NeedLab/face-mask-disinfection-device/docs/V2 box arduino wiring.jpg

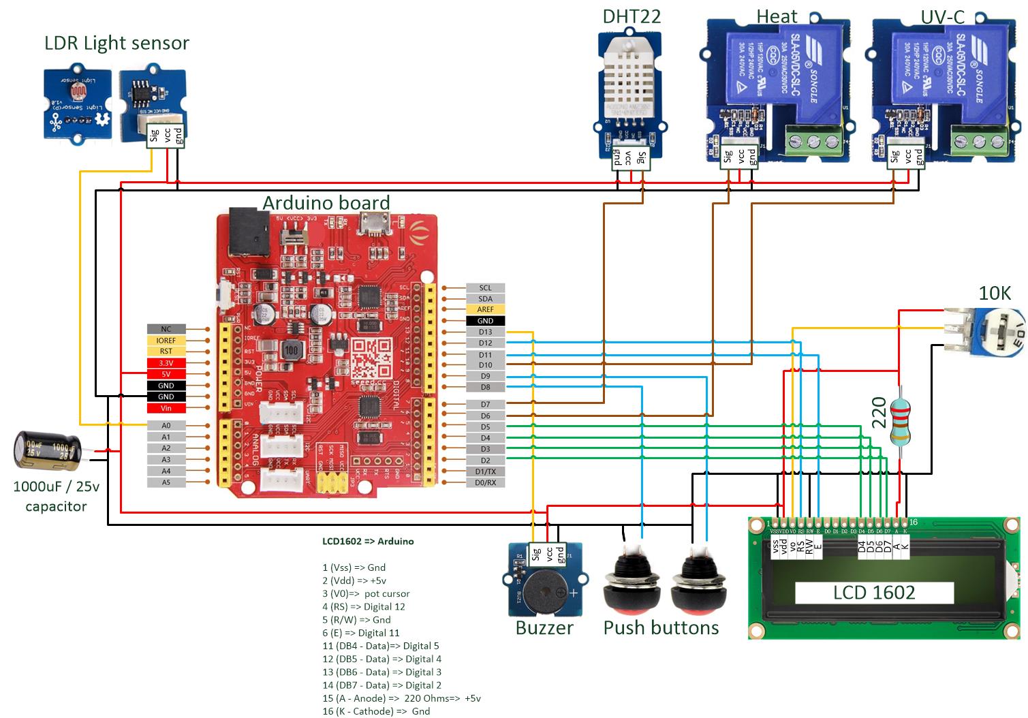
docs/V2 box arduino wiring.jpg
