NeedLab/face-mask-disinfection-device/docs/V2-schematics.jpg

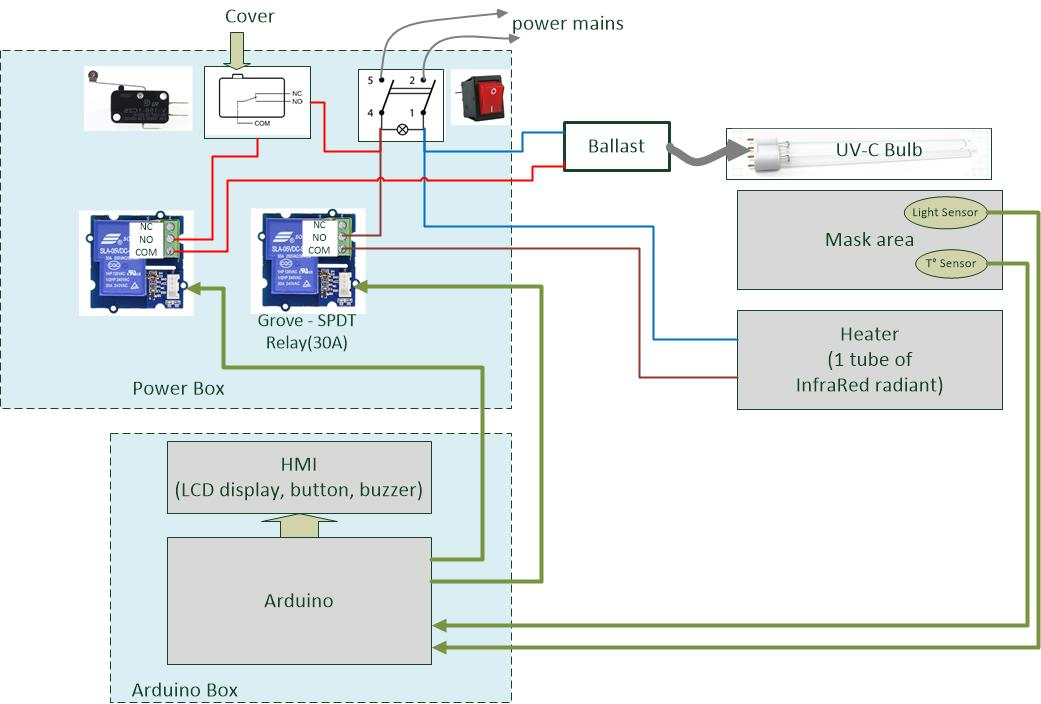
docs/V2-schematics.jpg
