NeedLab/face-mask-disinfection-device/docs/Face Mask Disinfection Device V2 BOM.xlsx

SETUP DISINFECTON BOX v2 | STUFF | Quantity | link
ARDUINO SETUP | Arduino board (Seeeduino) | 1 | https://www.seeedstudio.com/Seeeduino-V4-2-p-2517.html
 | prototyping shield | 1 | https://www.seeedstudio.com/Protoshield-Kit-for-Arduino-p-318.html
 | LCD display | 1 | https://www.seeedstudio.com/LCD-16-2-Characters-Green-Yellow-back-light-p-62.html
 | LCD display (alternative) |  | https://www.seeedstudio.com/Grove-16x2-LCD-White-on-Blue.html
 | Light sensor | 1 | https://www.seeedstudio.com/Grove-Light-Sensor-p-1253.html
 | temperature & humidity sensor DHT22 | 1 | https://www.seeedstudio.com/Grove-Temperature-Humidity-Sensor-Pro-AM2302-DHT22.html
 | Relay | 2 | https://www.seeedstudio.com/Grove-SPDT-Relay-30A.html
 | 12mm Domed Push Button Pack | 1 | https://www.seeedstudio.com/12mm-Domed-Push-Button-Pack-p-1304.html
 | Buzzer | 1 | https://www.seeedstudio.com/Grove-Buzzer.html
 | Grove - 4 pin Male Jumper to Grove 4 pin Conversion Cable (5 PCs per Pack) | 1 | https://www.seeedstudio.com/Grove-4-pin-Male-Jumper-to-Grove-4-pin-Conversion-Cable-5-PCs-per-Pack.html
 | 1000uF 25v capacitor
 | wall adapter supply | 1 | https://www.seeedstudio.com/Wall-Adapter-Power-Supply-12VDC-1-2A-Includes-5-adapter-plugs.html
ELECTRIC SETUP | Miniature Basic Switch | 1 | https://fr.rs-online.com/web/p/microrupteurs/6822786/
 | manual switch | 1 | https://fr.rs-online.com/web/p/interrupteurs-a-bascule/1858229/
 | UV-C lamp & Ballast | 1 | https://www.aqua-store.fr/filtre-sterelisateur-uv-aquarium/9731-aqua-nova-steriliser-36-w-filtre-uv-pour-aquarium-5907747866294.html
 | Infra Red Heater | 1 | https://fr.trotec.com/shop/radiant-infrarouge-electrique-ir-1200-s.html
VARIOUS STUFF | Aluminium tape | 1 | https://fr.rs-online.com/web/p/rubans-aluminium/0176573/
 | lockers (2x pack) | 1 | https://fr.rs-online.com/web/p/fermetures-a-bascule/1974110/
 | hinges (2X pack) | 1 | https://fr.aliexpress.com/item/4000093145544.html
 | Metal plate | 1
 | wood | tbd
