NeedLab/face-mask-disinfection-device/docs/V2-pin-mapping.ods

UNO | LCD1602 | Grove LCD | Piezo Buzzer | BPs | Relay Heat | Relay UV-C | DHT22 | Adafruit UV sensor | Grove Light Sensor
GND | 1 - GND | GND | GND | GND | GND | GND | GND | GND | GND
GND | 5 -R/W
5V | 2 - VDD | VCC |  |  | VCC | VCC | VCC | VCC | VCC
D2 | 14 - DB7
D3 | 13 - DB6
D4 | 12 - DB5
D5 | 11 - DB4
D6 |  |  |  |  | SIG
D7 |  |  |  |  |  |  | OUT
D8 |  |  |  | Mode
D9 |  |  |  | Start / Stop
D10 |  |  |  |  |  | SIG
D11 | 6- E
D12 | 4 - RS
D13 (Led) |  |  | SIG
A0 |  |  |  |  |  |  |  | OUT | SIG
A1
A2
A3
A4 (SDA) |  | SDA
A5 (SCL) |  | SCL
D0 (Tx)
D1 (Rx)
