NeedLab/face-mask-disinfection-device/design/Electronics-power-Box-thck5.pdf

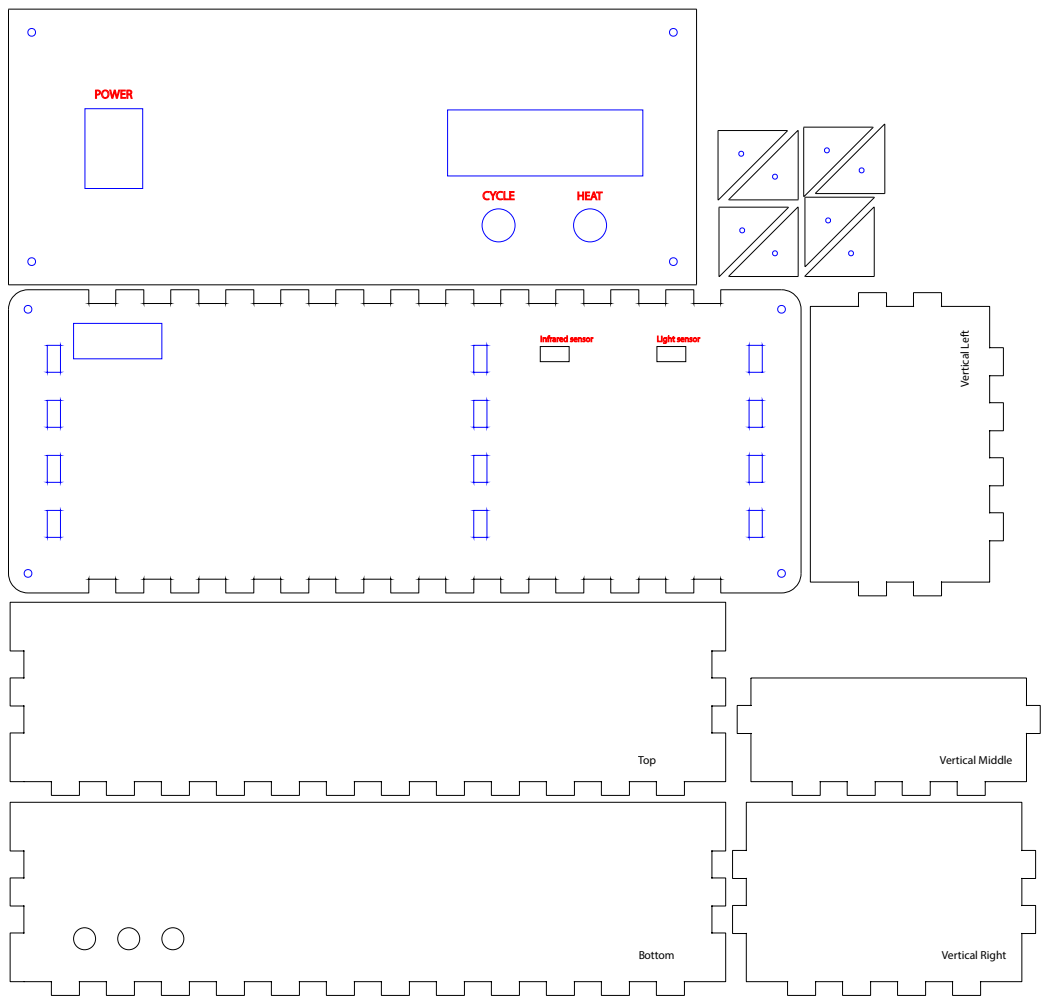
[picture p3: page 1]
Bottom; Top; Vertical Middle

Vertical Right Vertical Left
