NeedLab/face-mask-disinfection-device/design/Laser-cutting-Big-Box-500x600-thck10-all.pdf

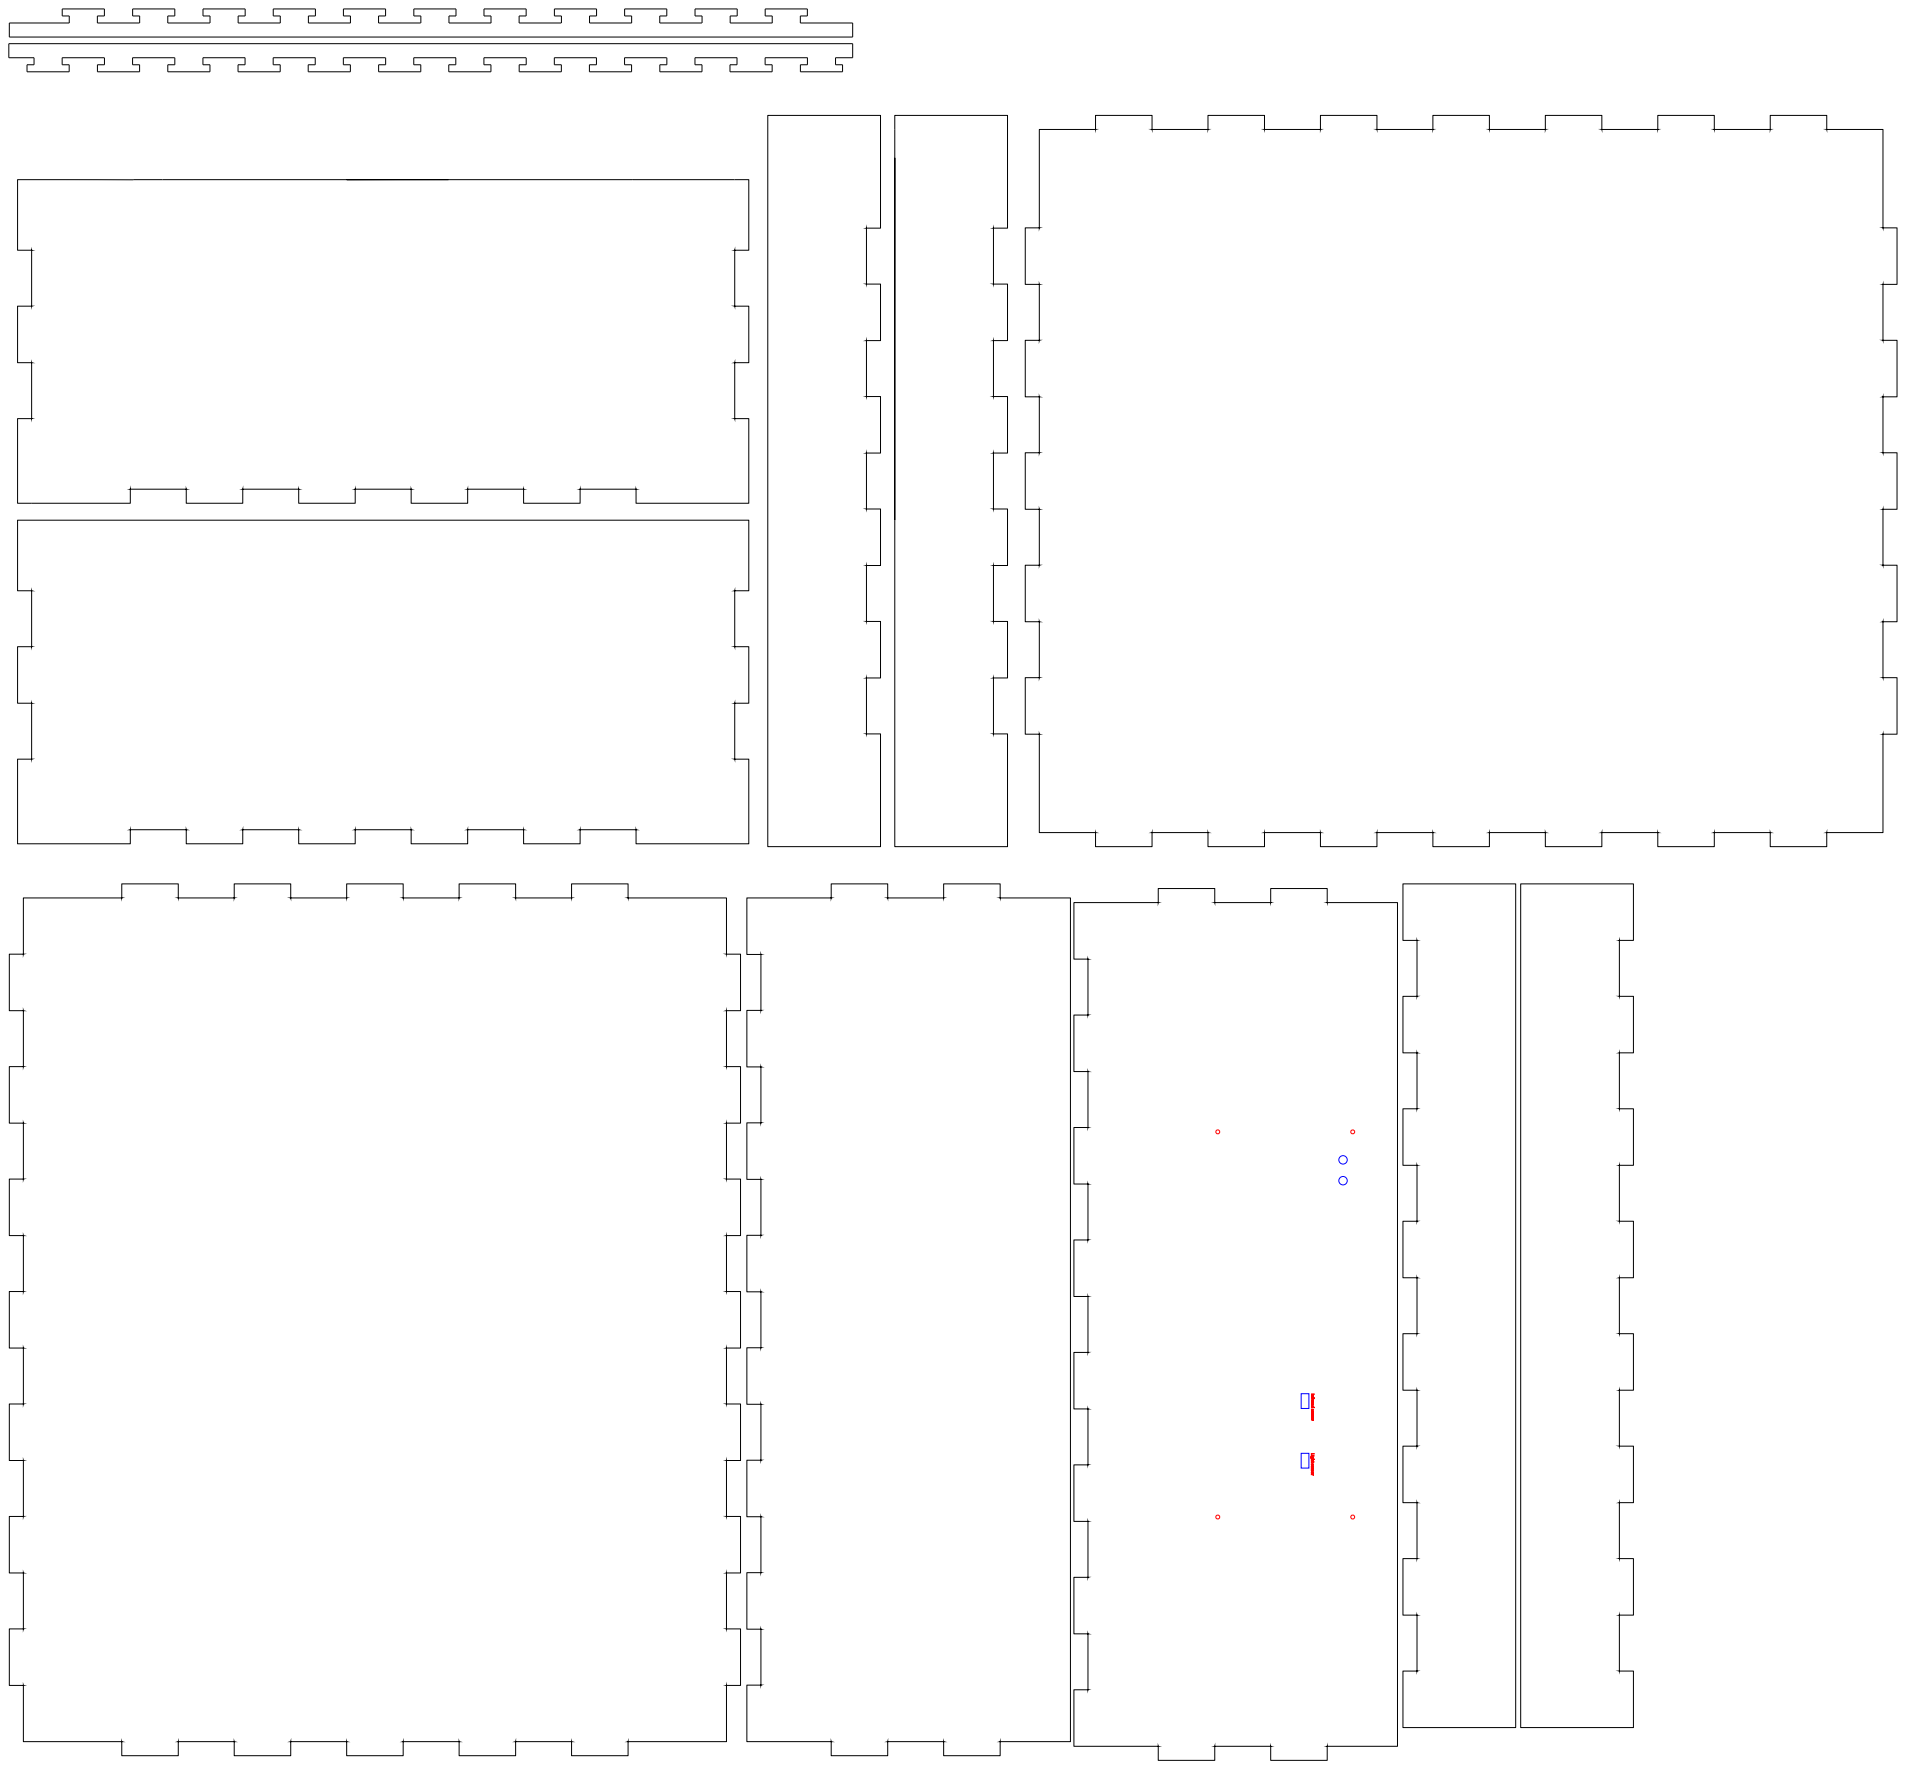
[picture p4: page 1]
