NeedLab/face-mask-disinfection-device/design/Laser-cutting-Big-Box-500x600-thck8-all.pdf

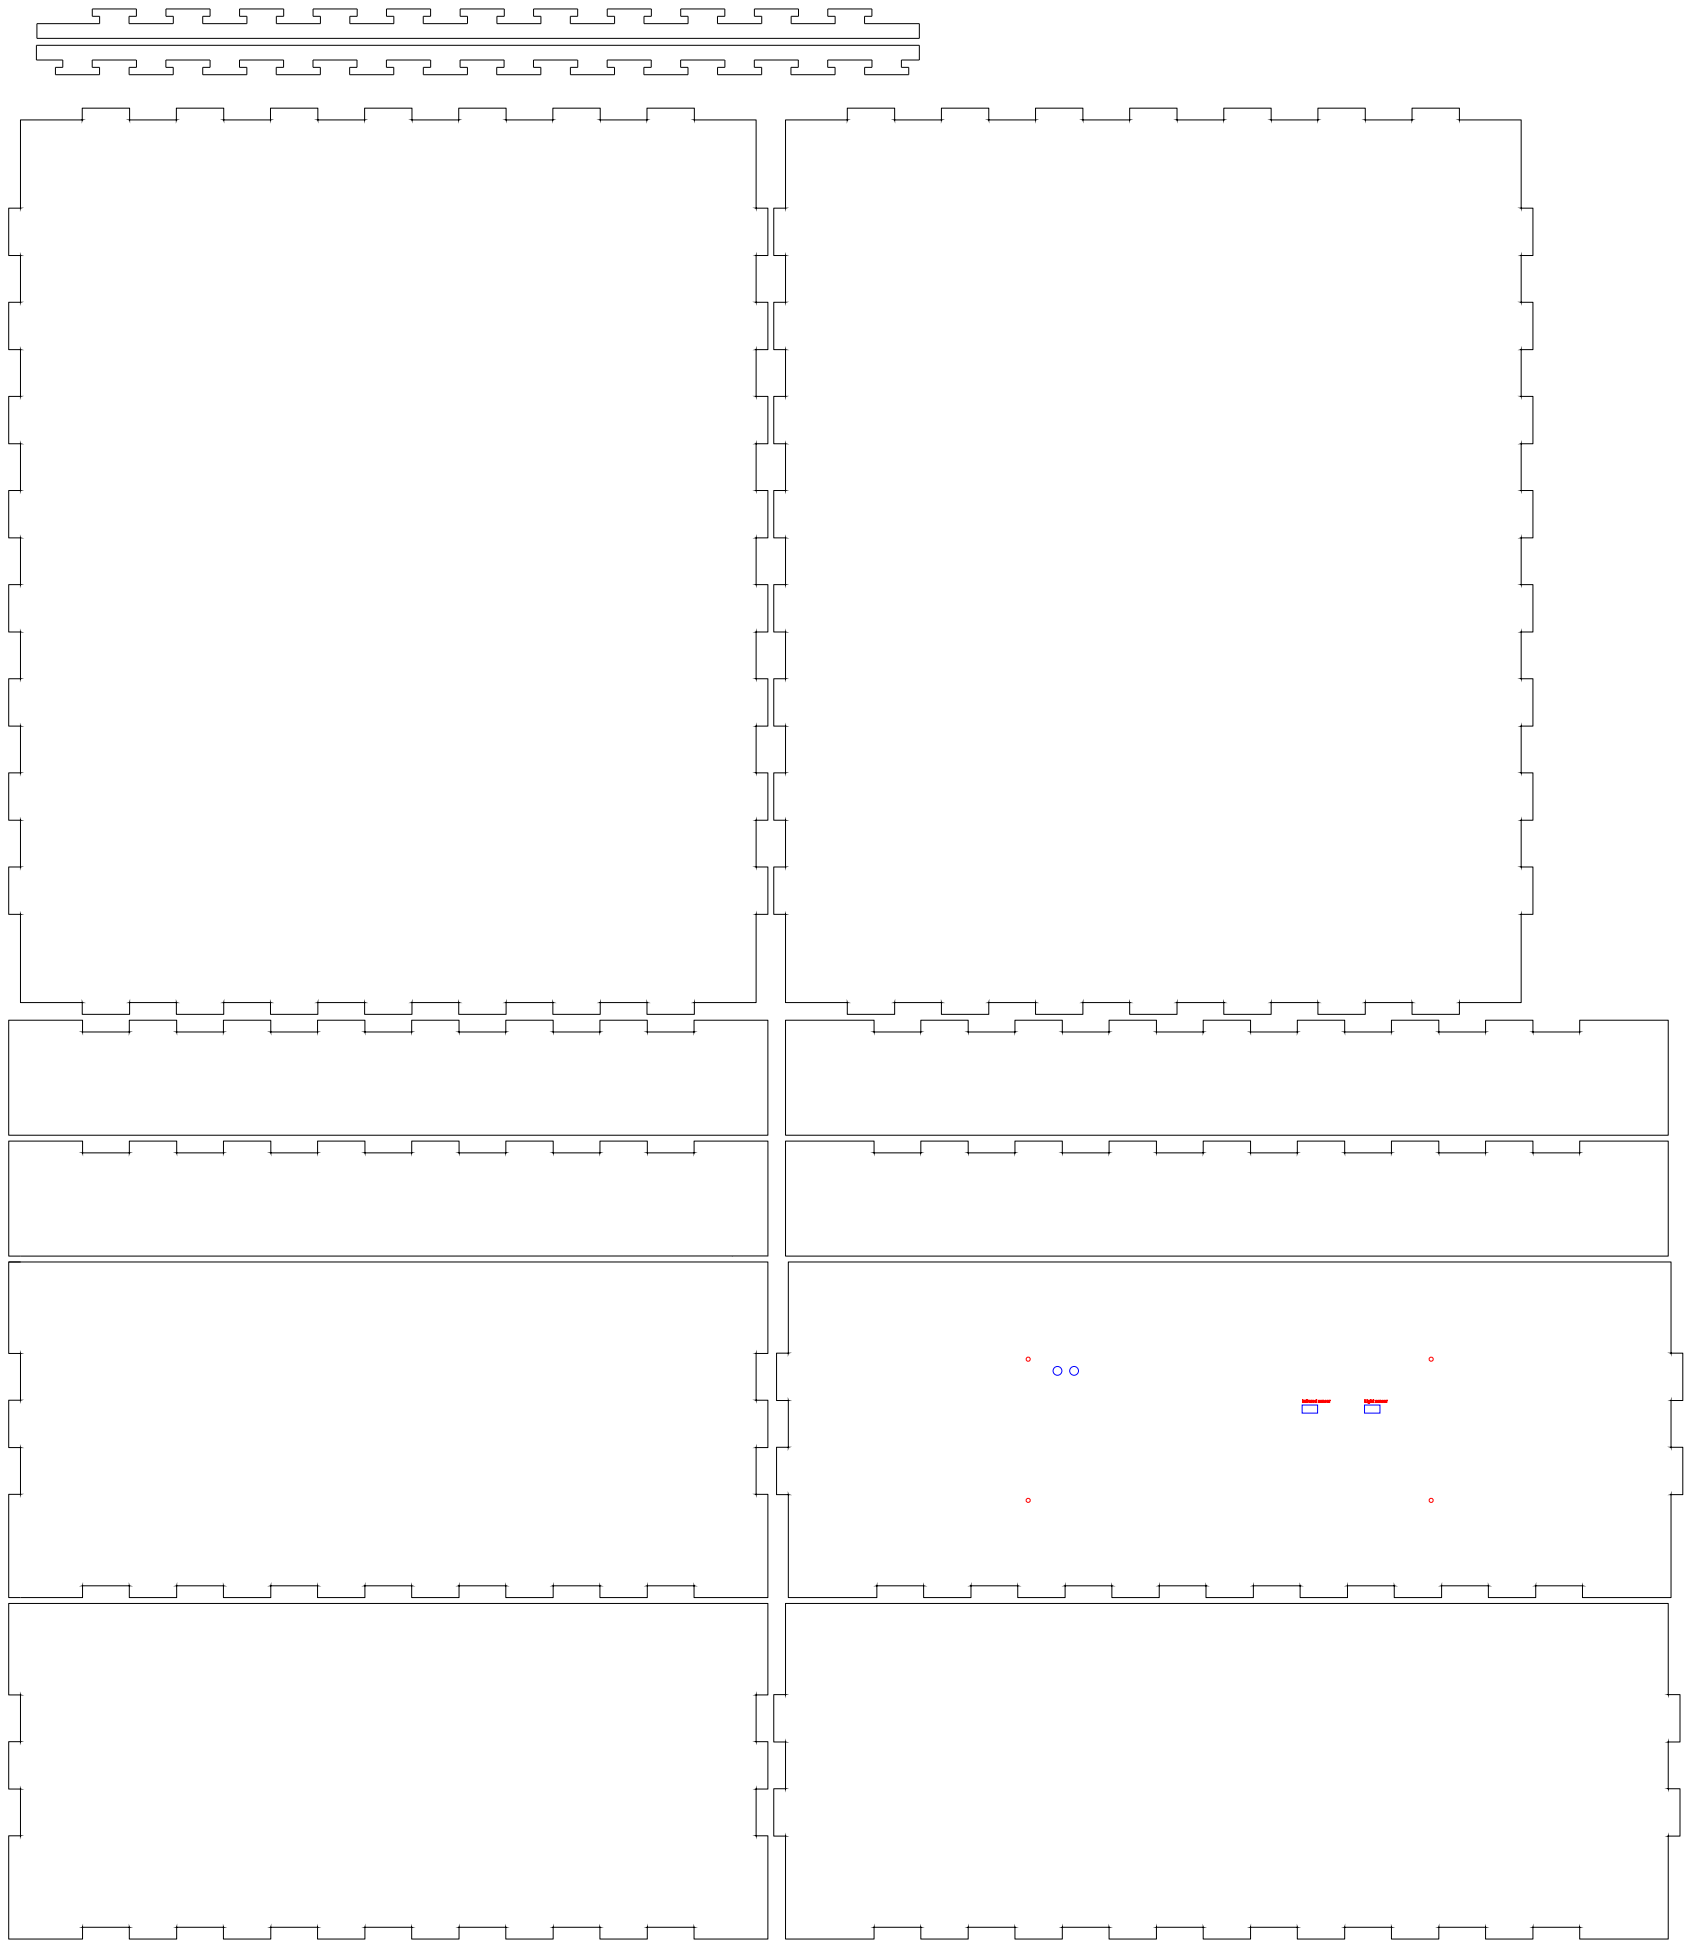
[picture p5: page 1]
