NeedLab/face-mask-disinfection-device/(commit log)

2020-06-09 adds BOM
    [V2 BOM.ods]
2020-06-09 adds arduino stuff
    [V2-pin-mapping.ods]
2020-06-10 refactoring of repo, adds 'docs' directory
    [V2-BOM.ods, V2-pin-mapping.ods]
2020-06-11 adds arduino wiring
